noredlace/ECEN404/Final Project Presentation - November 14th, 2018.pdf

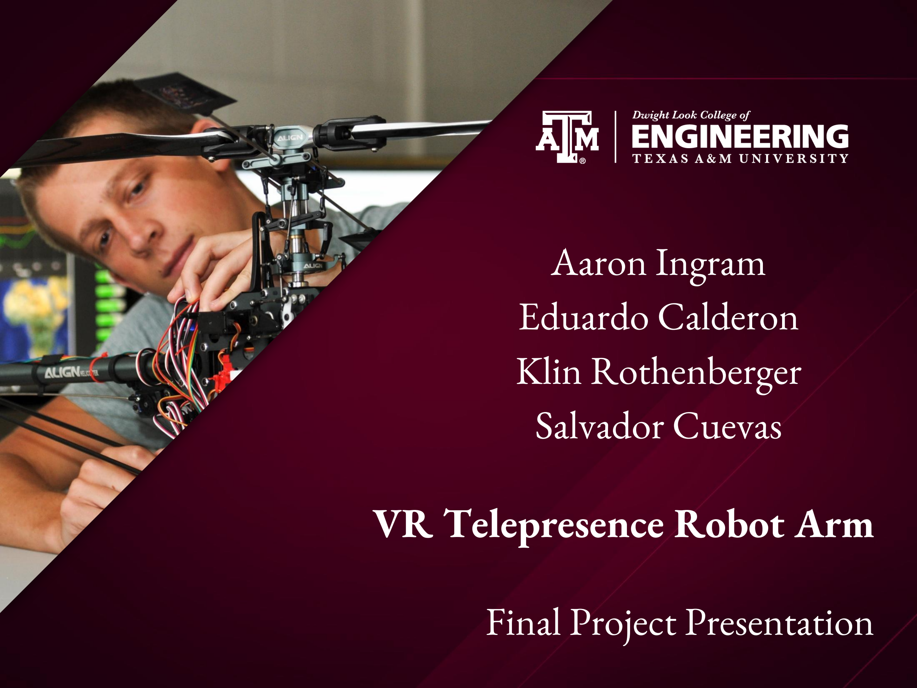
[picture p43: page 1]

# VR Telepresence Robot Arm

# Final Project Presentation

# Aaron Ingram Eduardo Calderon Klin Rothenberger Salvador Cuevas

# Problem Statement

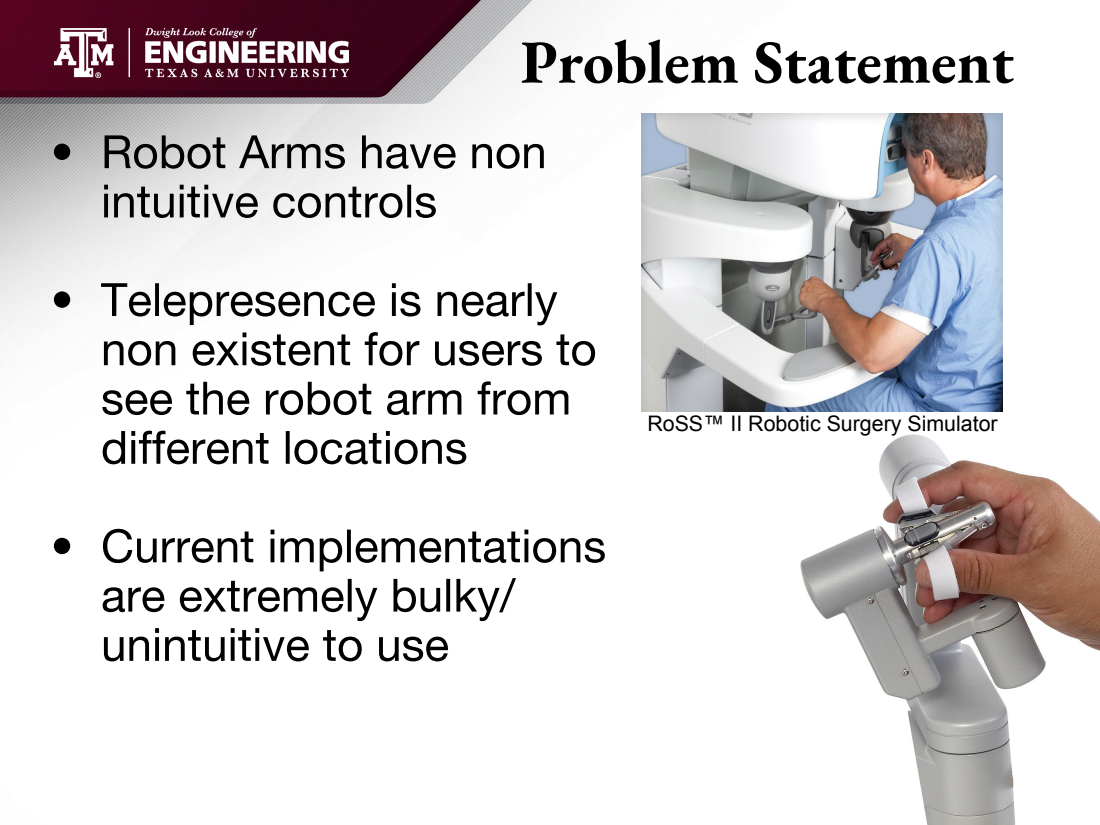
[picture p44: page 2]

RoSS™ II Robotic Surgery Simulator

# Original Concept

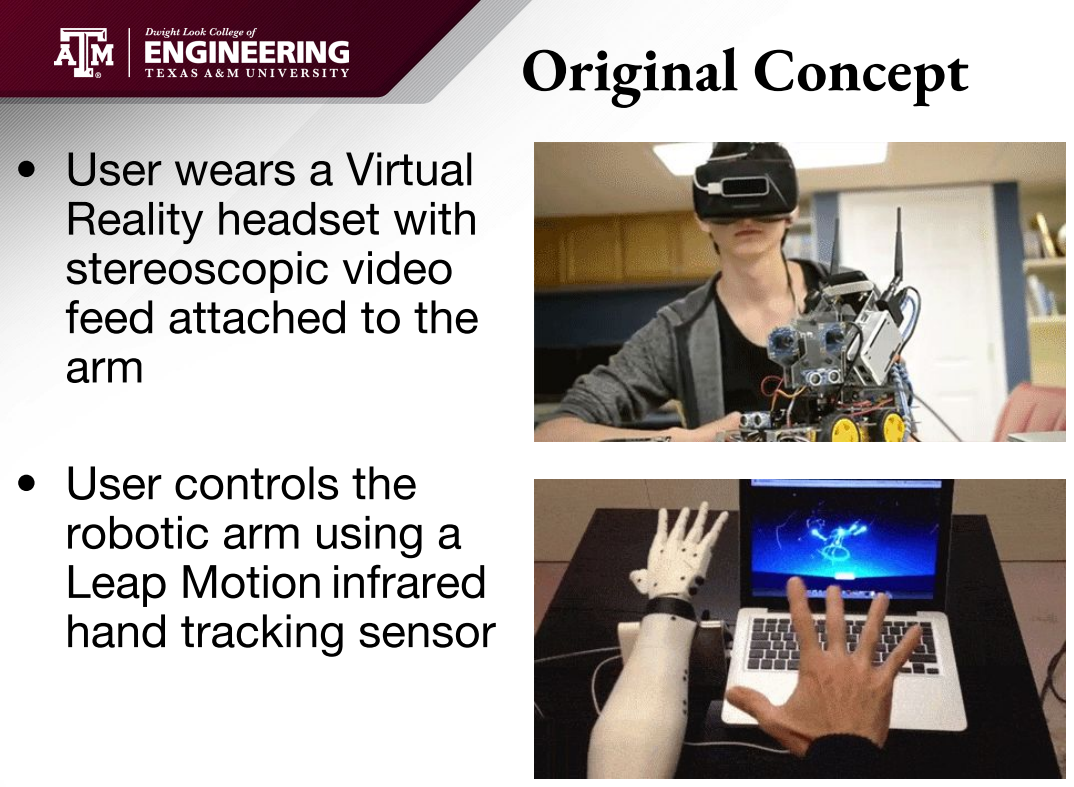
[picture p45: page 3]

# System Overview

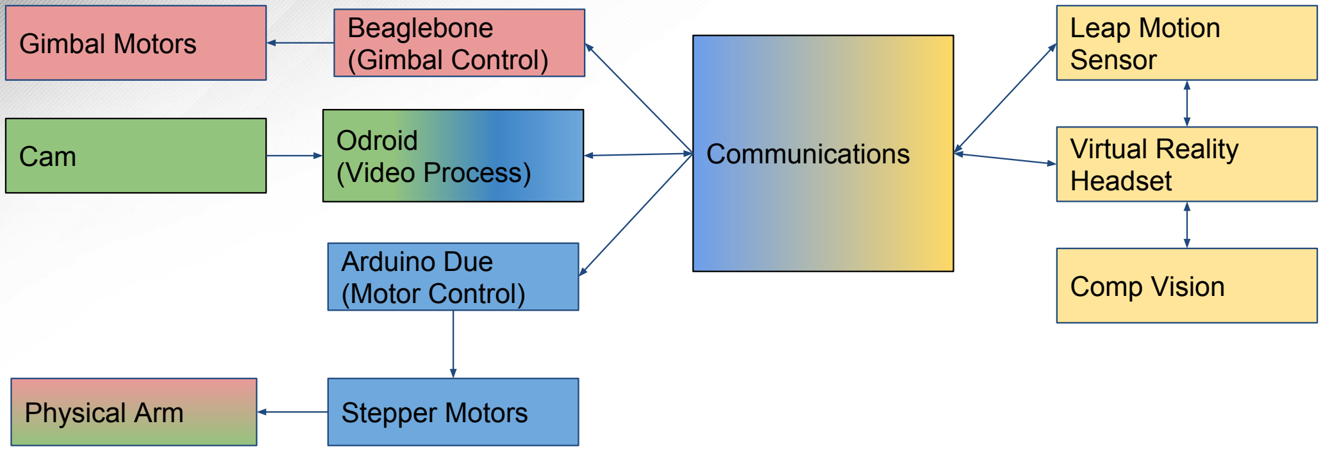
[picture p46: figure]
Cam; Odroid; (Video Process); Communications; Leap Motion Sensor; Virtual Reality Headset; Comp Vision; Physical Arm; Stepper Motors; Beaglebone (Gimbal Control) Gimbal Motors; Arduino Due (Motor Control)

Klin

Salvador

Aaron

E.J.

# Communications and Control Subsystem

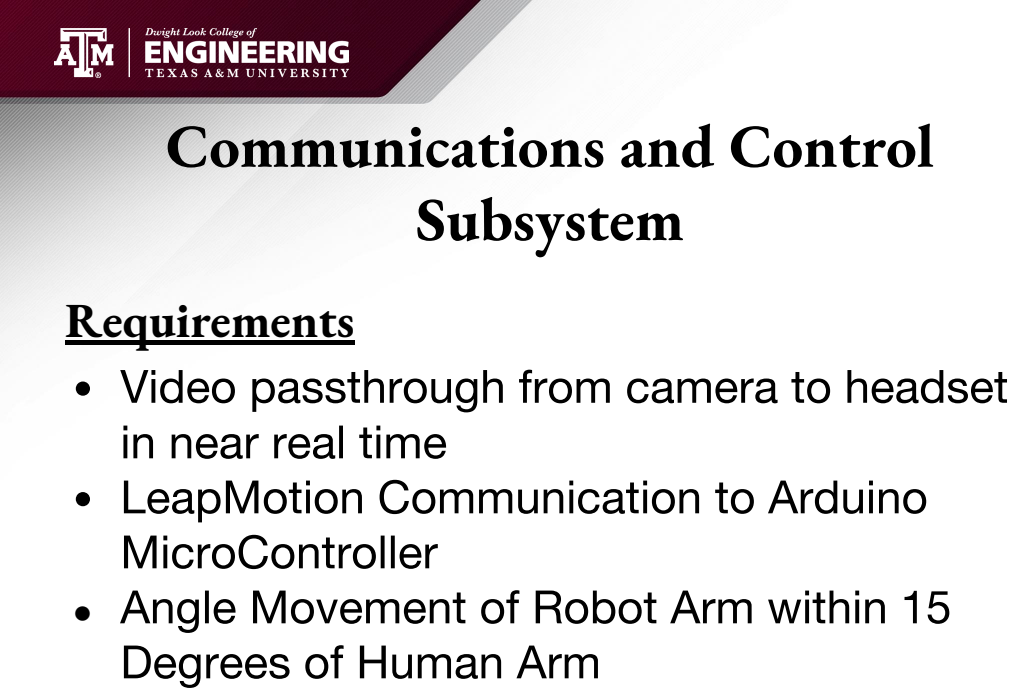
[picture p47: page 5]
Requirements

# World Interaction While wearing Headset

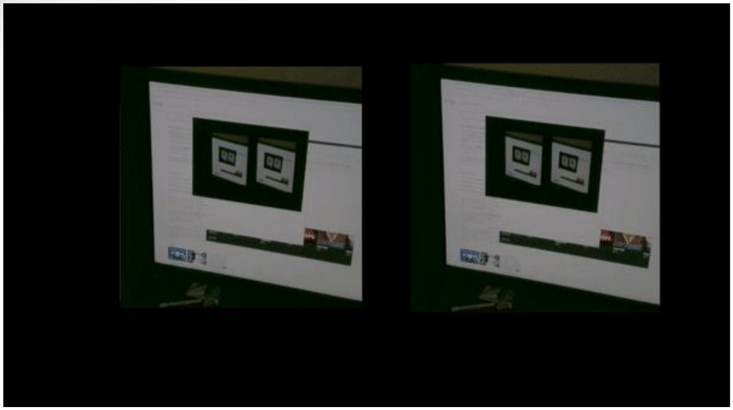
[picture p48: figure]

# Communications Testing

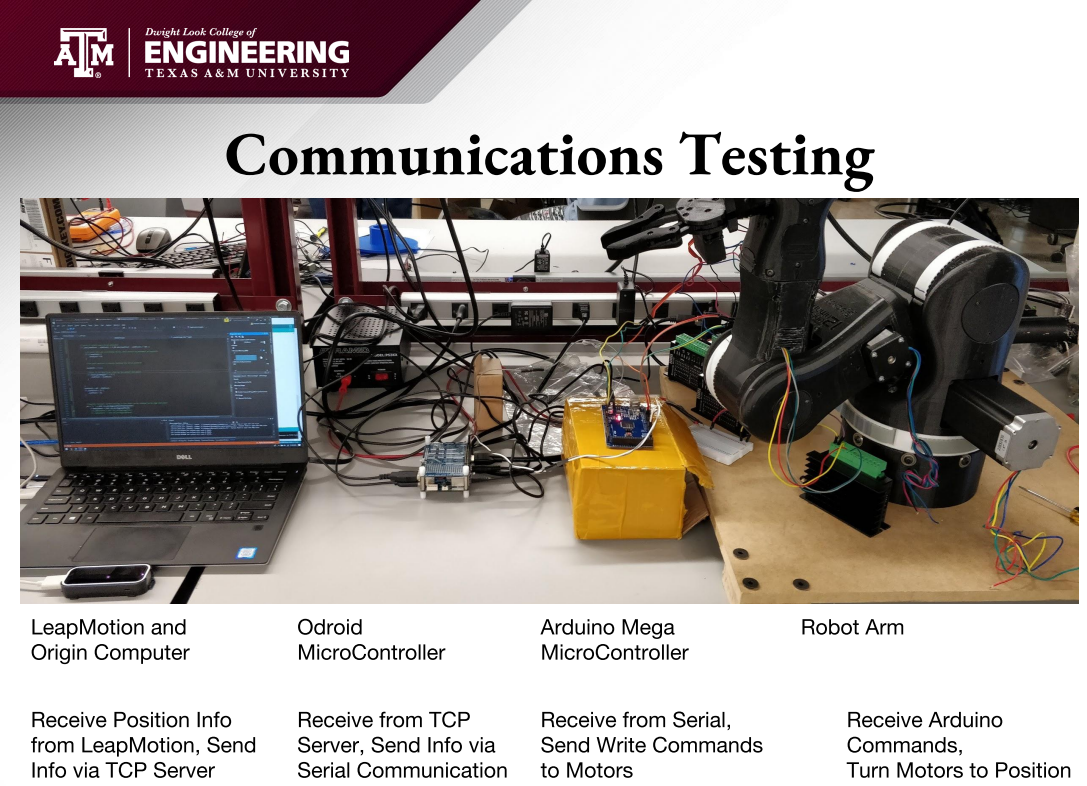
[picture p49: page 7]

# Communications Testing

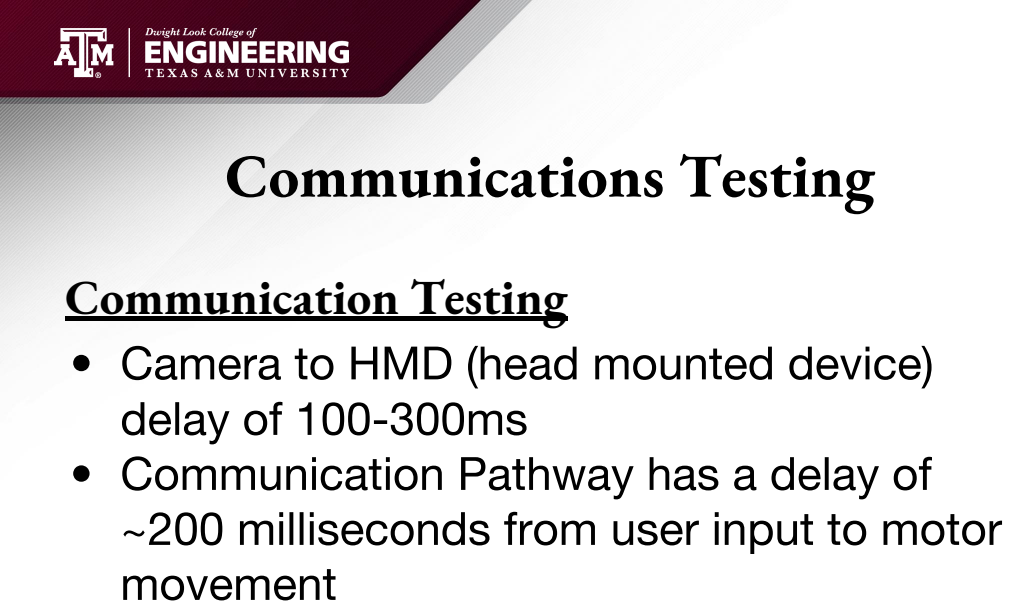
[picture p50: page 8]
Communication Testing

# Motor Control Testing

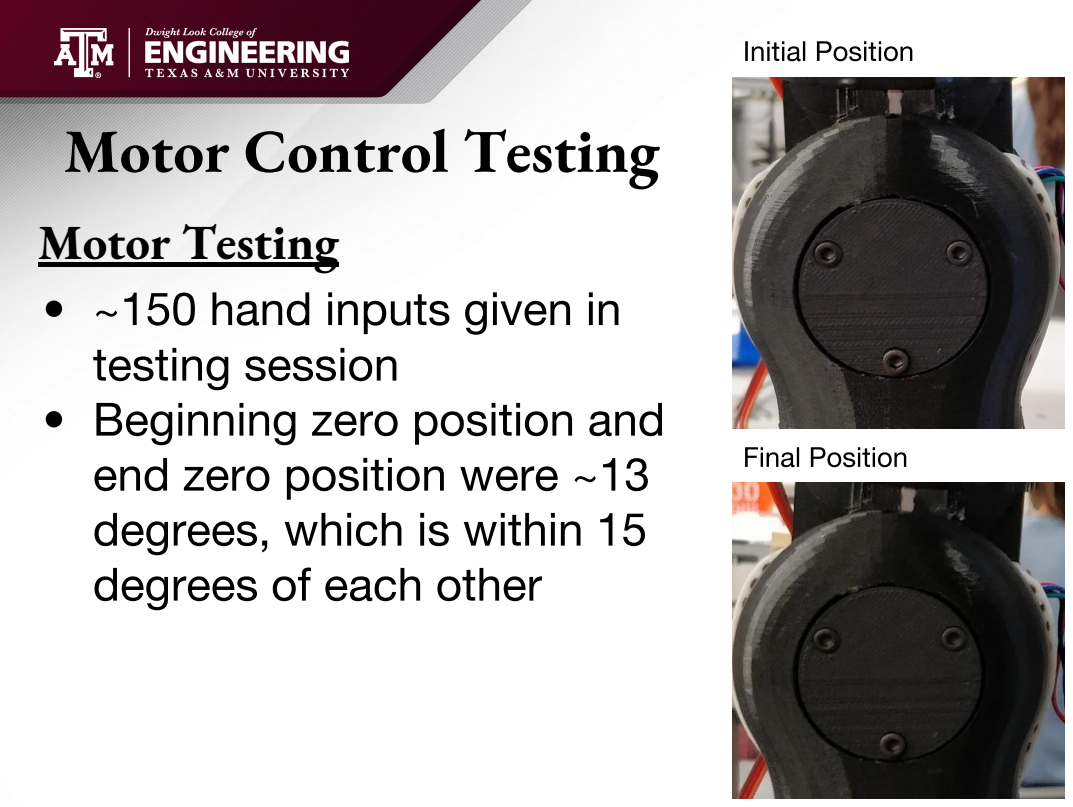
[picture p51: page 9]
Motor Testing

# Grabber Testing

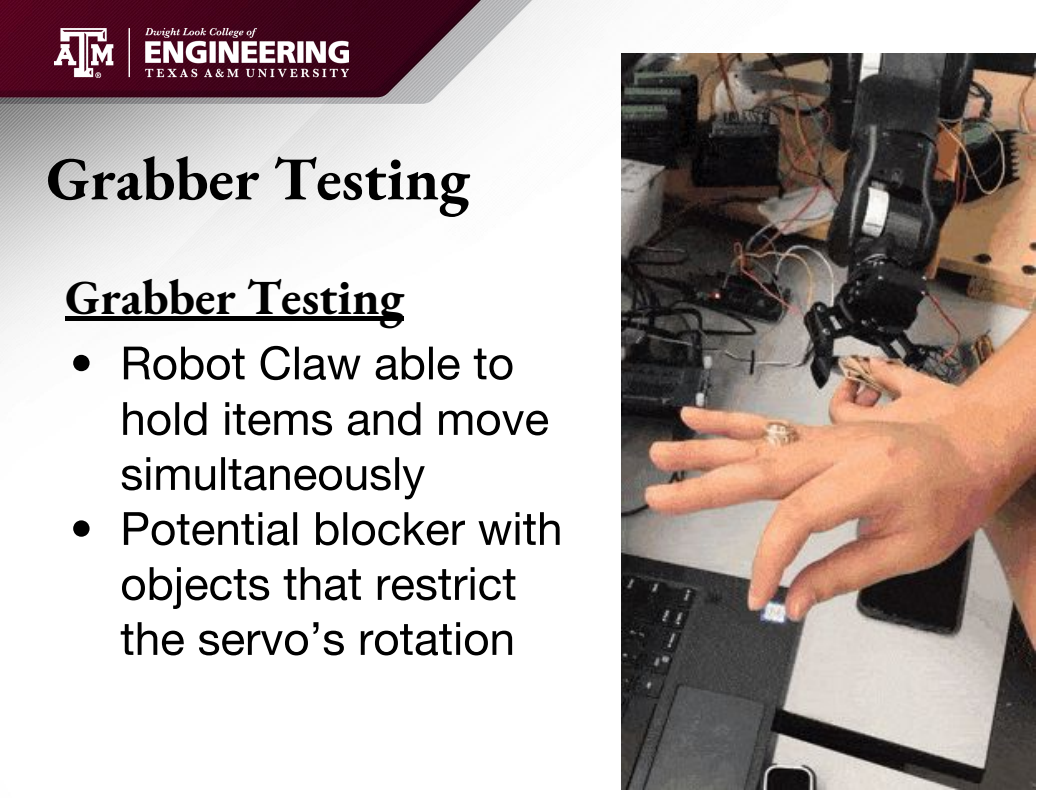
[picture p52: page 10]
Grabber Testing

# Arm/Camera Subsystem

# Requirements

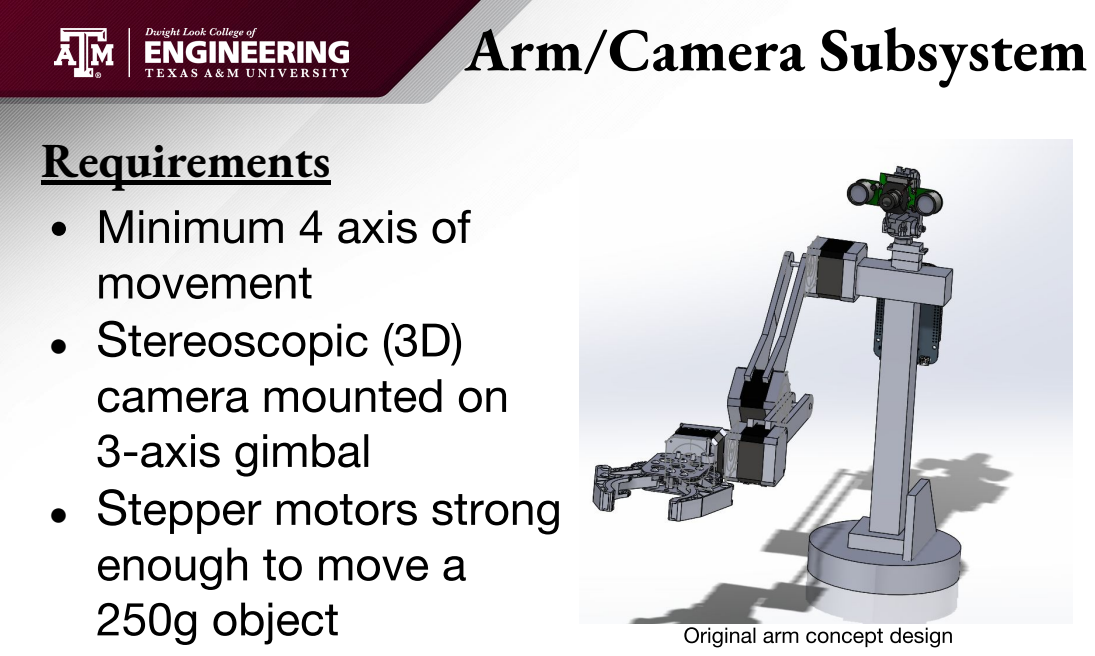
[picture p53: page 11]

# Final Arm Design

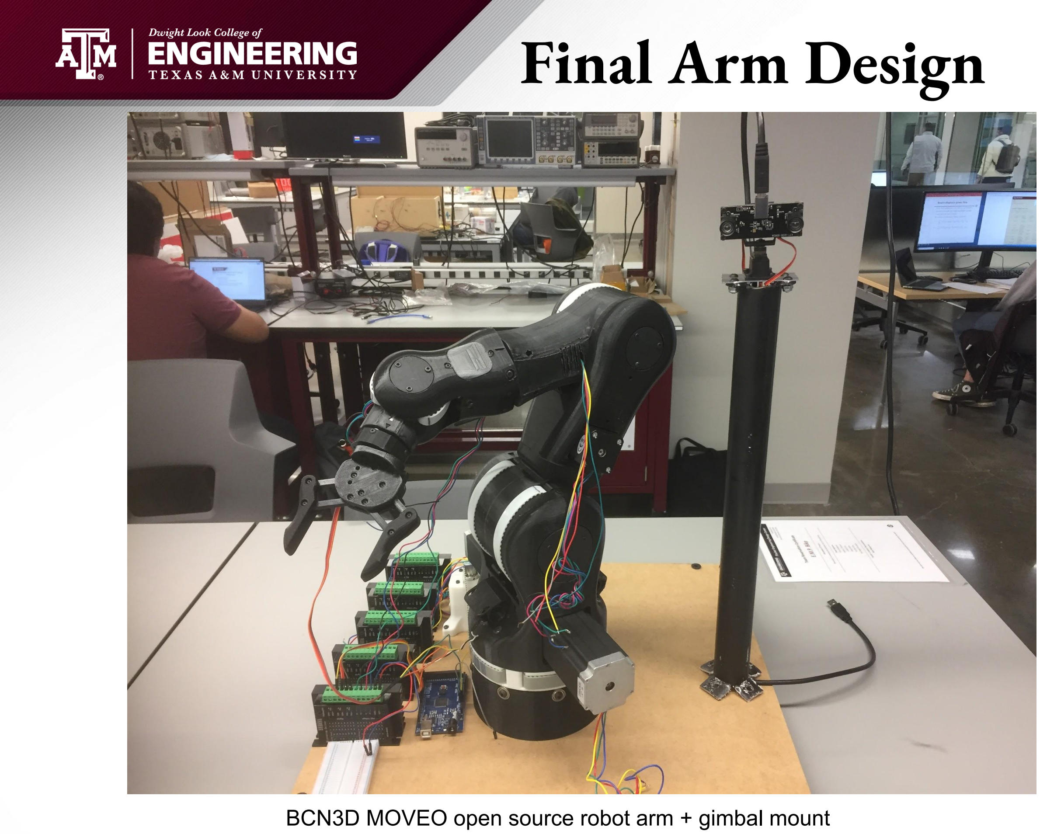
[picture p54: page 12]

BCN3D MOVEO open source robot arm + gimbal mount

# Camera + Gimbal

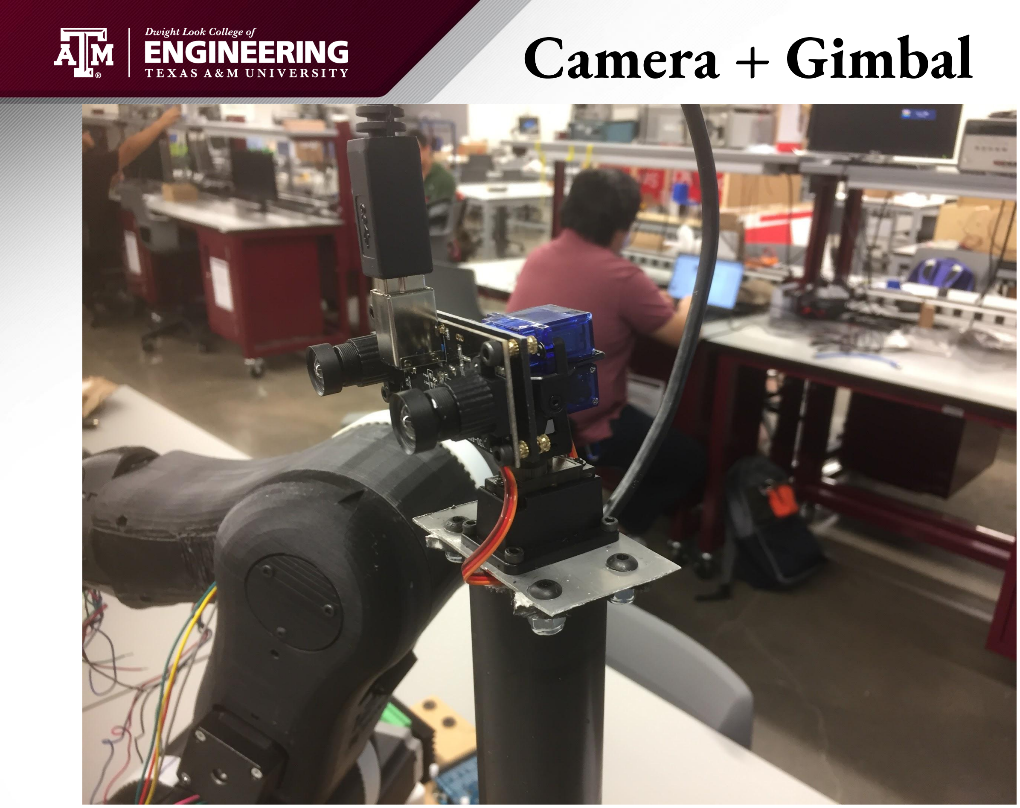
[picture p55: page 13]
